nkallen/trigon/back.png

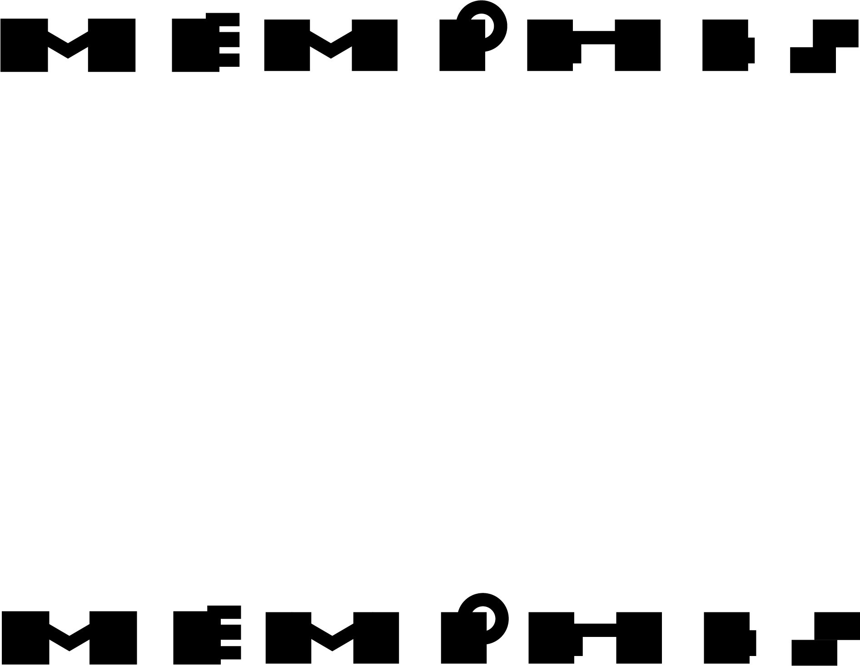
back.png
