nkallen/trigon/side.png

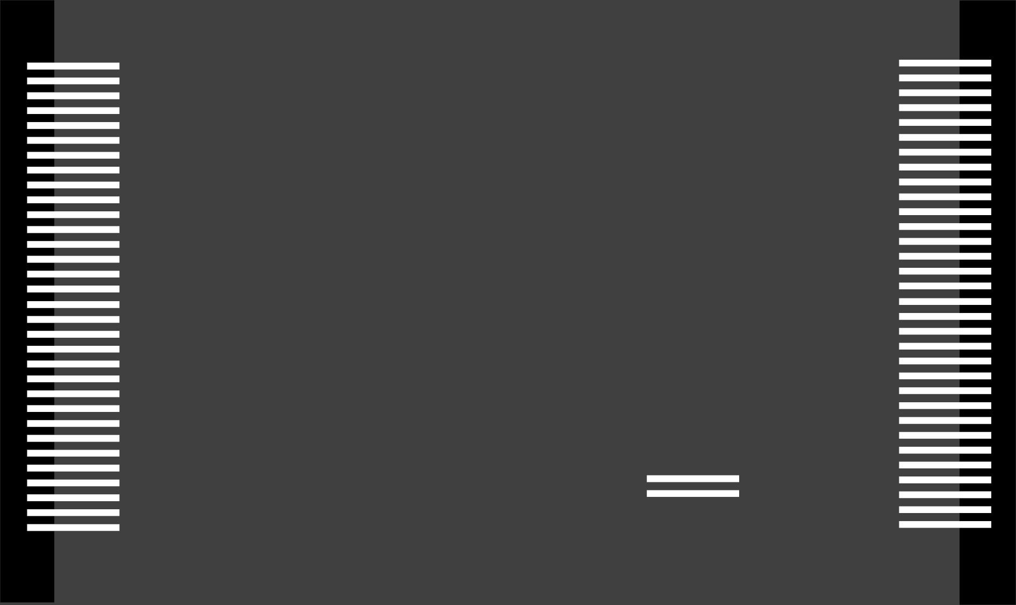
side.png
