nkallen/trigon/Gerbers/Trigon-Edge_Cuts.dxf

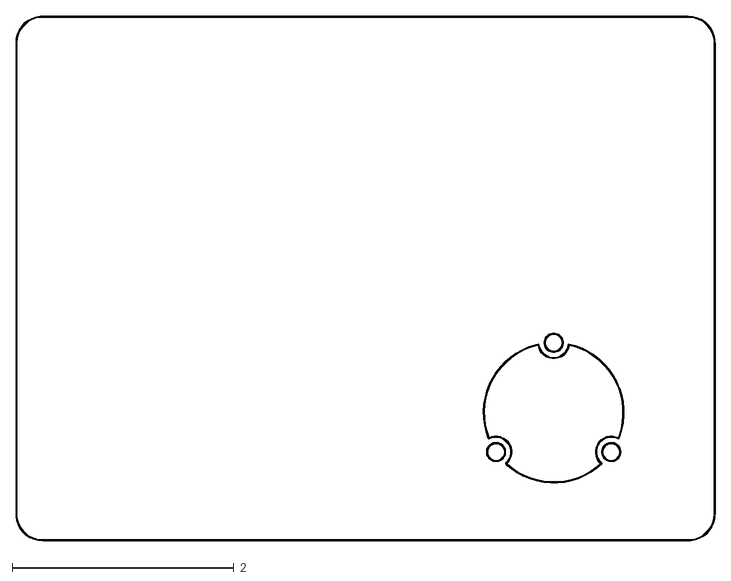
[picture p3: CAD file, 2021-04-19]
Gerbers/Trigon-Edge_Cuts.dxf
6.31 x 4.73
