nkallen/trigon/Case/Switch Plate v2.dxf

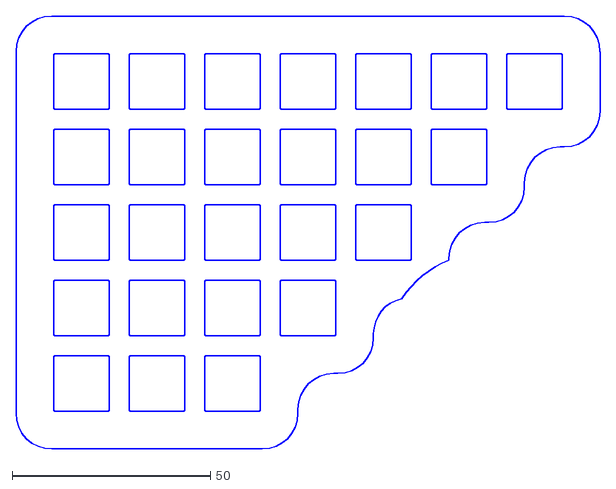
[picture p4: CAD file, 2021-04-19]
Case/Switch Plate v2.dxf
147.3 x 109.2
