nkallen/trigon/Case/backplate.dxf

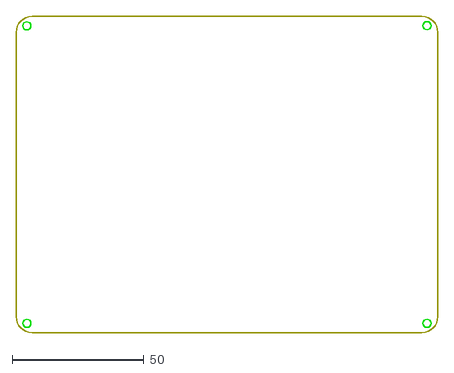
[picture p5: CAD file, 2021-04-19]
Case/backplate.dxf
160.0 x 120.0
