nkallen/trigon/Case/pcb 5.dxf

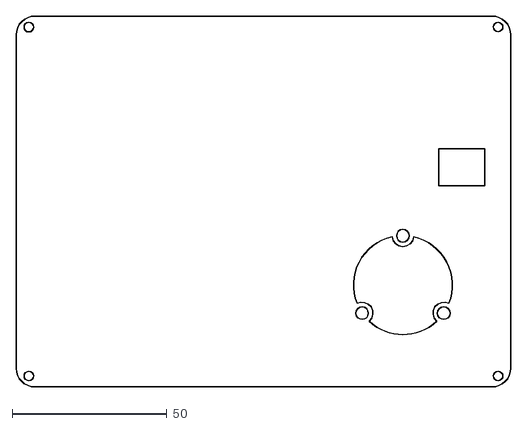
[picture p6: CAD file, 2020-09-24]
Case/pcb 5.dxf
160.0 x 120.0
