nkallen/trigon/Case/pcb 4.dxf

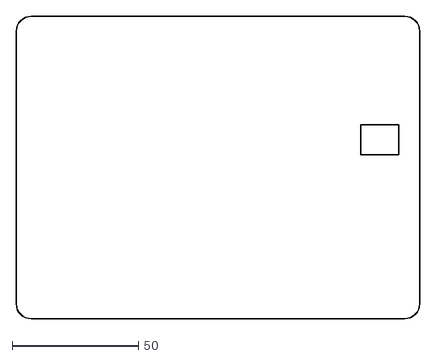
[picture p7: CAD file, 2020-09-24]
Case/pcb 4.dxf
160.0 x 120.0
