nkallen/trigon/Case/pcb 3.dxf

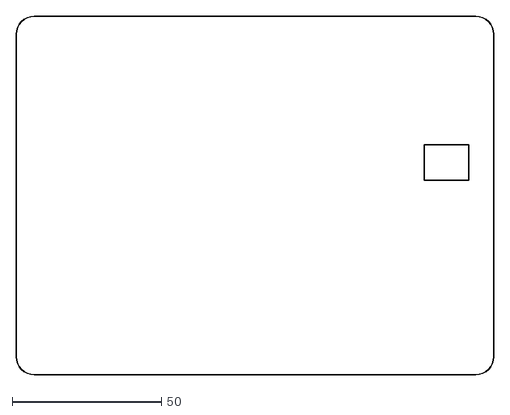
[picture p8: CAD file, 2020-09-24]
Case/pcb 3.dxf
160.0 x 120.0
