nkallen/trigon/Case/pcb.dxf

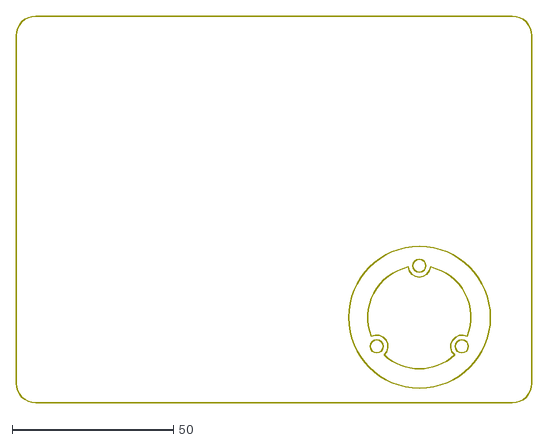
[picture p9: CAD file, 2020-09-11]
Case/pcb.dxf
160.0 x 120.0
