nkallen/trigon/(list of files, cad)

Other CAD files:
Case/Keyboard.dwg
Case/bottom.dxf
Case/top.dxf
Case/open 2.dxf
Case/open 0.dxf
Case/mount.dxf
Case/open 1.dxf
Case/open 3.dxf
Case/Switch Plate v1.dxf
Case/Switch Plate v0.dxf
