nkallen/trigon/Case/case.pdf

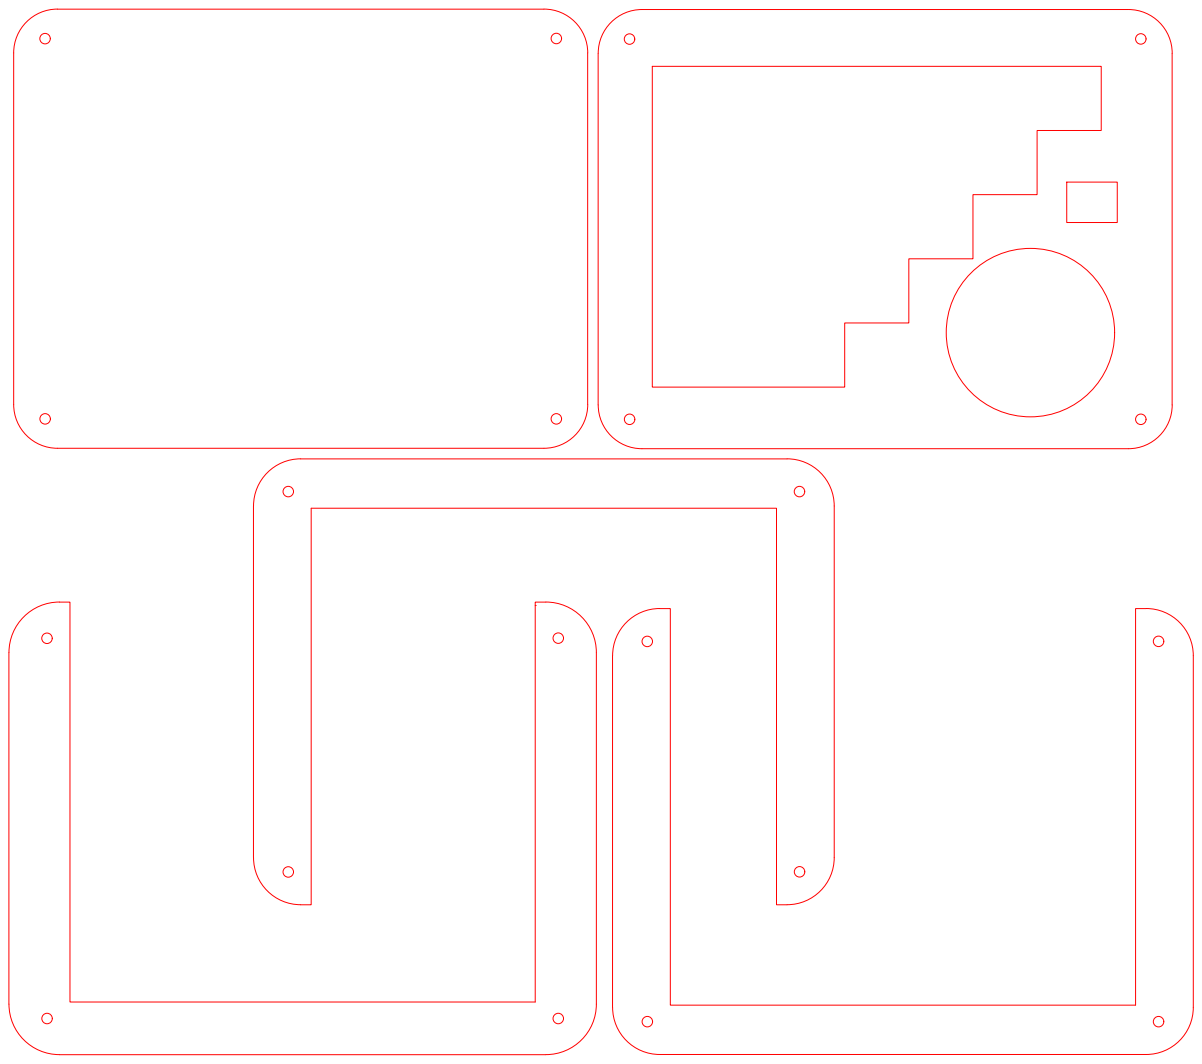
[picture p10: page 1]
