nkallen/trigon/Gerbers/Trigon-Edge_Cuts.pdf

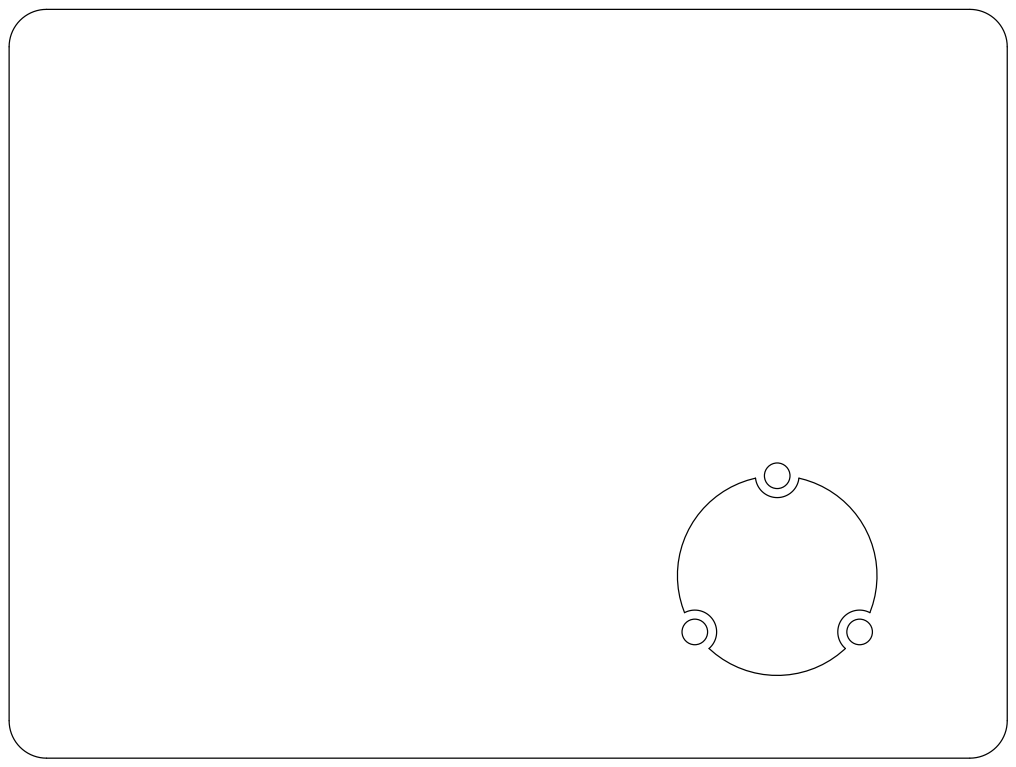
[picture p11: page 1]
