nkallen/trigon/Gerbers/Trigon-F_Cu.pdf

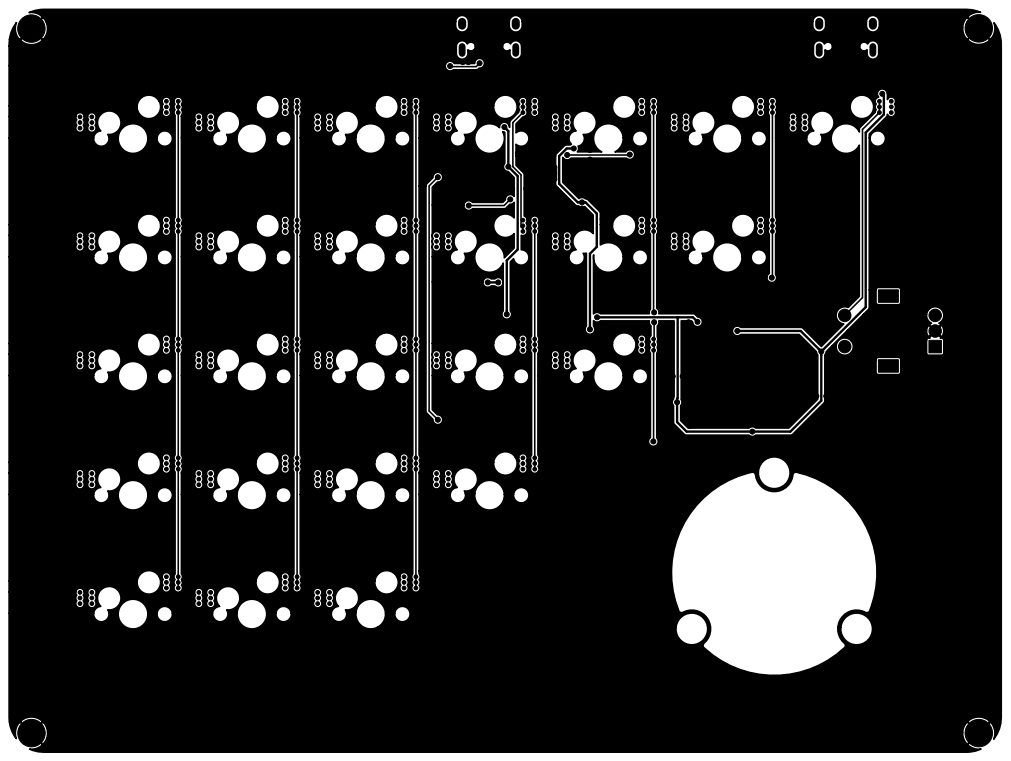
[picture p12: page 1]
