nkallen/trigon/Gerbers/Trigon-F_Fab.pdf

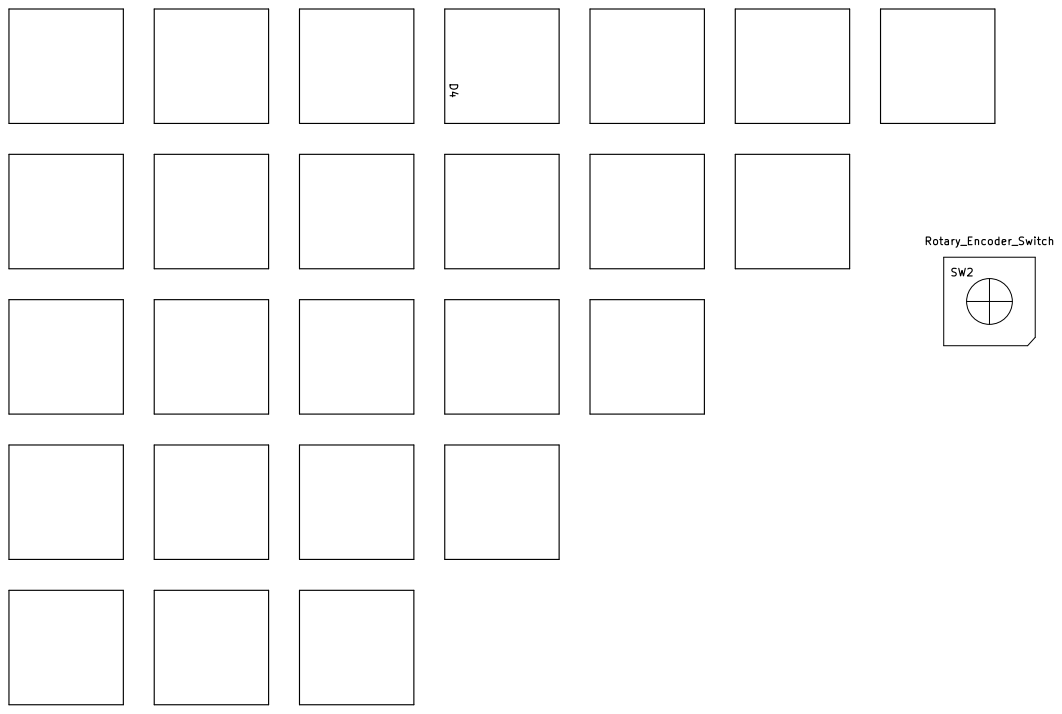
[picture p13: page 1]
