nkallen/trigon/Hardware/Trigon.kicad_pcb

## KiCad design Hardware/Trigon.kicad_pcb (2021-04-20)

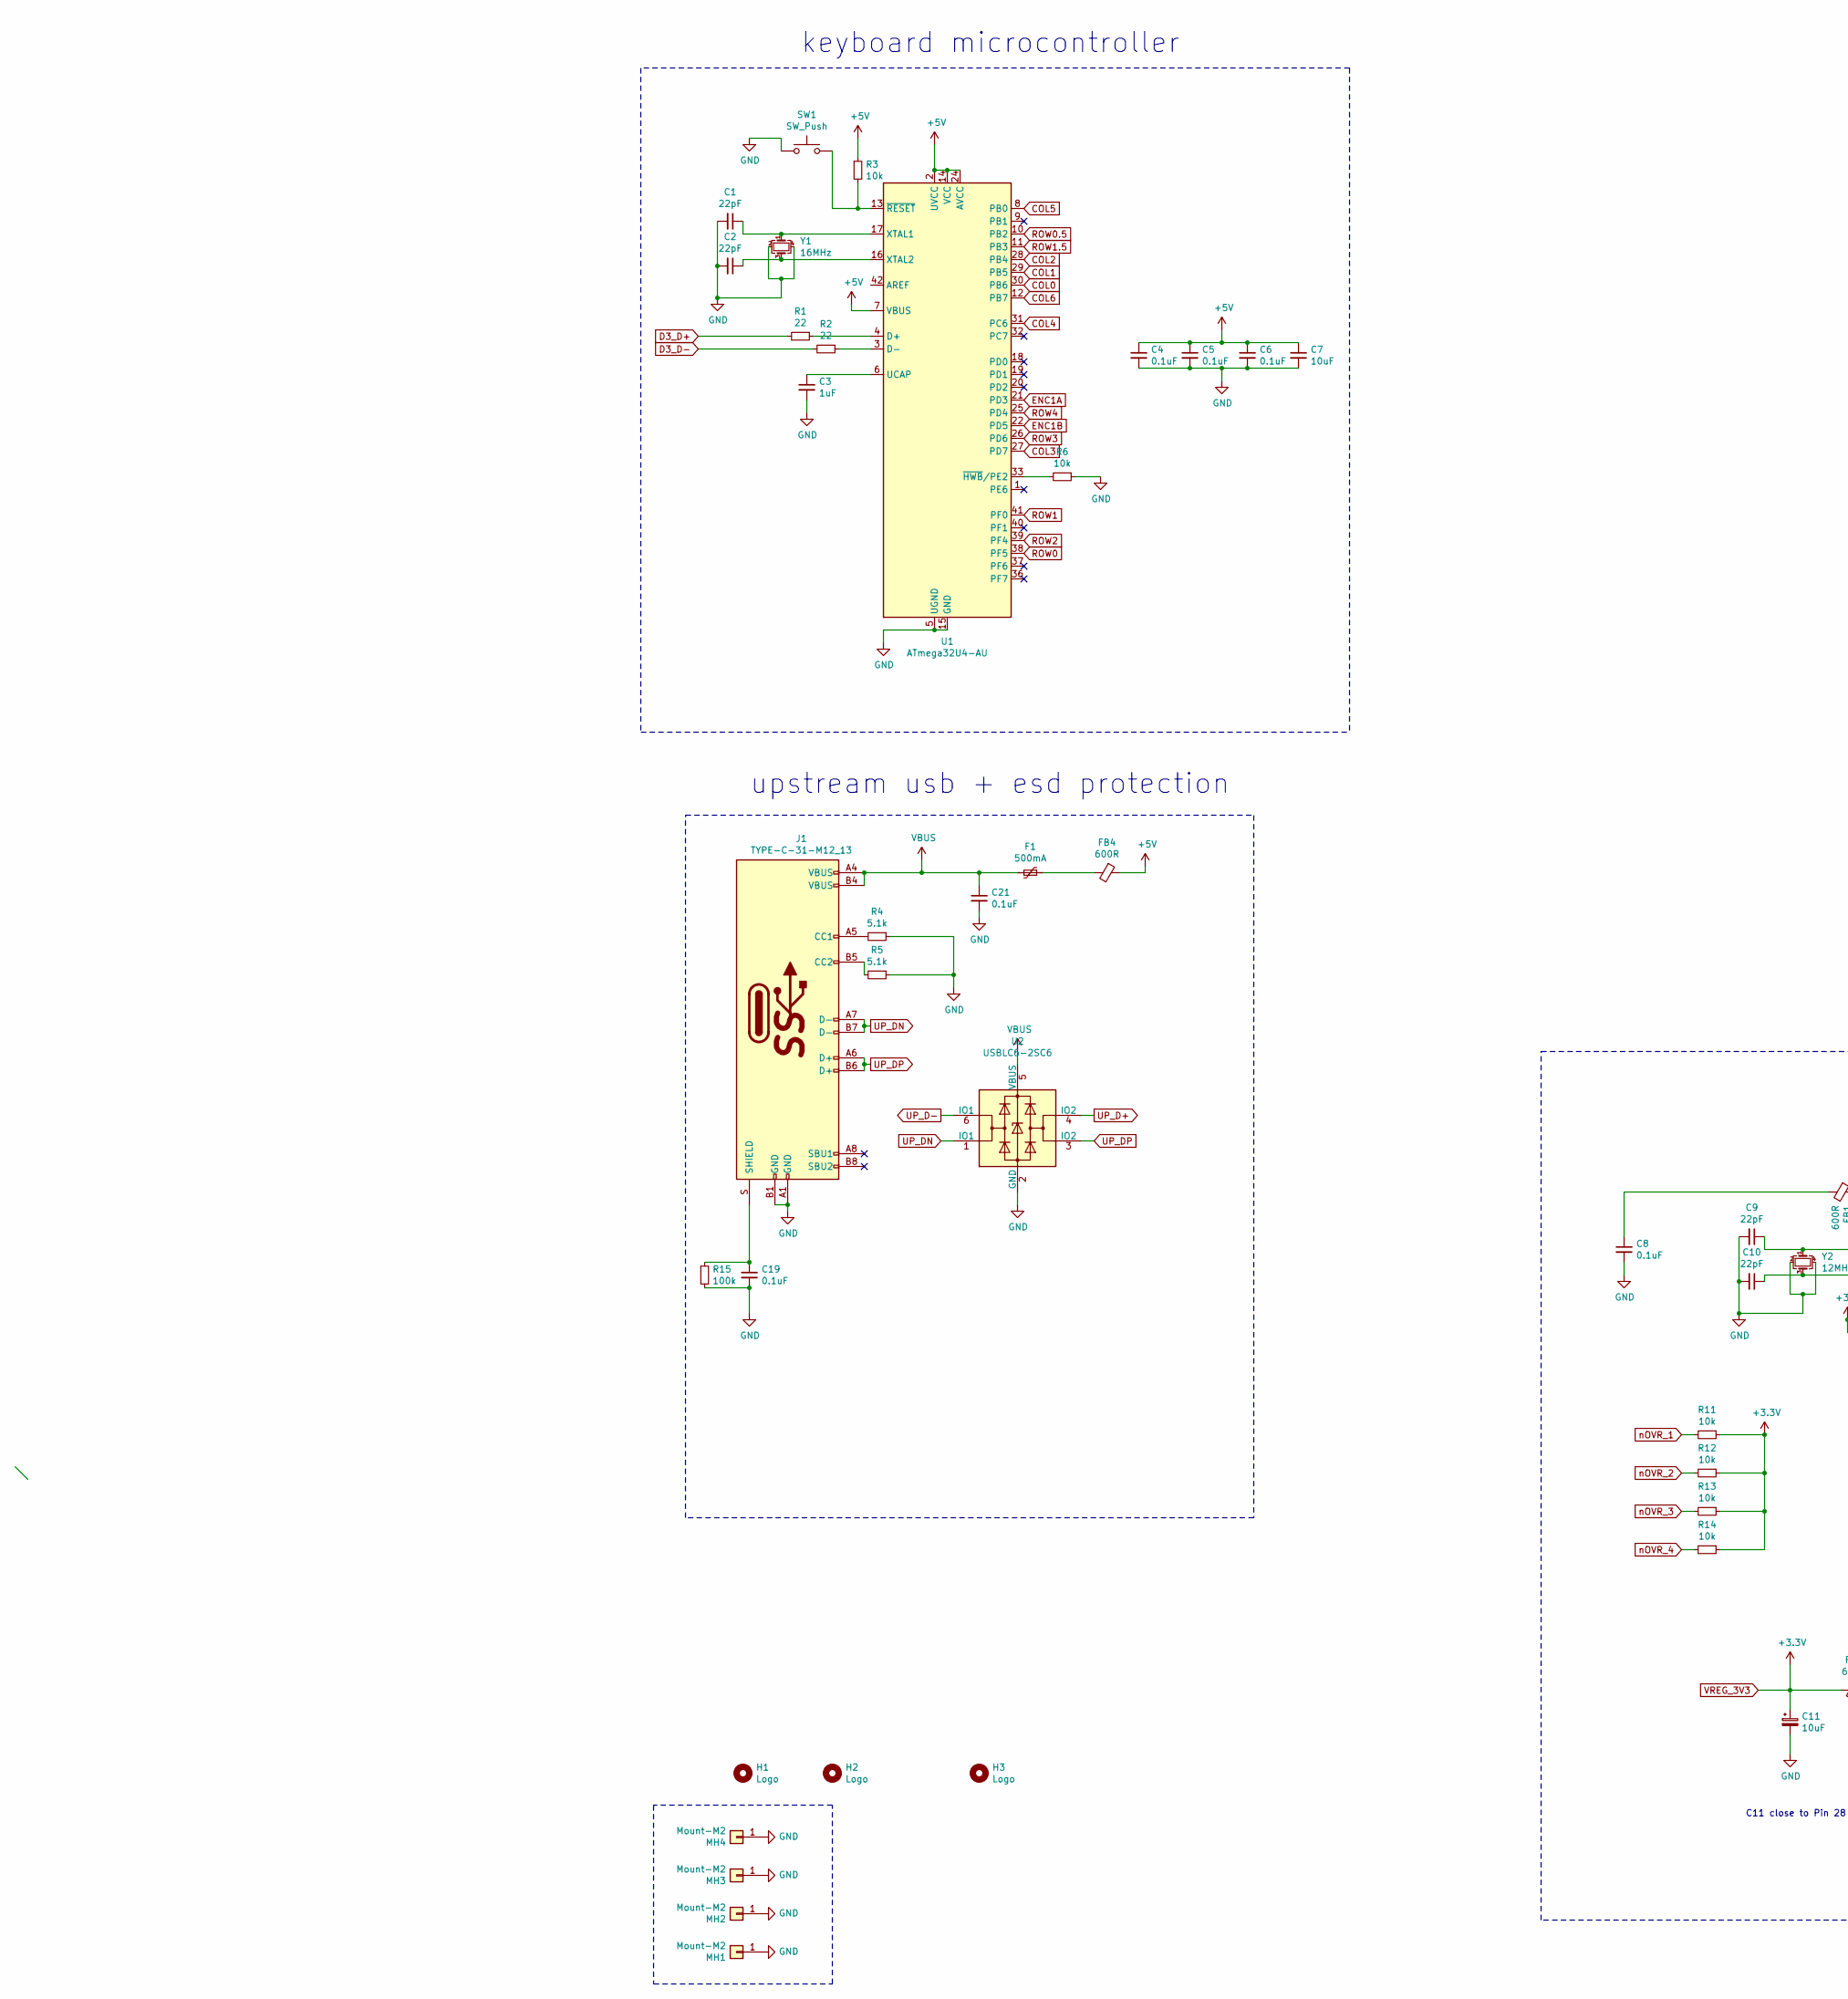
[picture p14: schematic Trigon.sch, part in row 1, column 1]

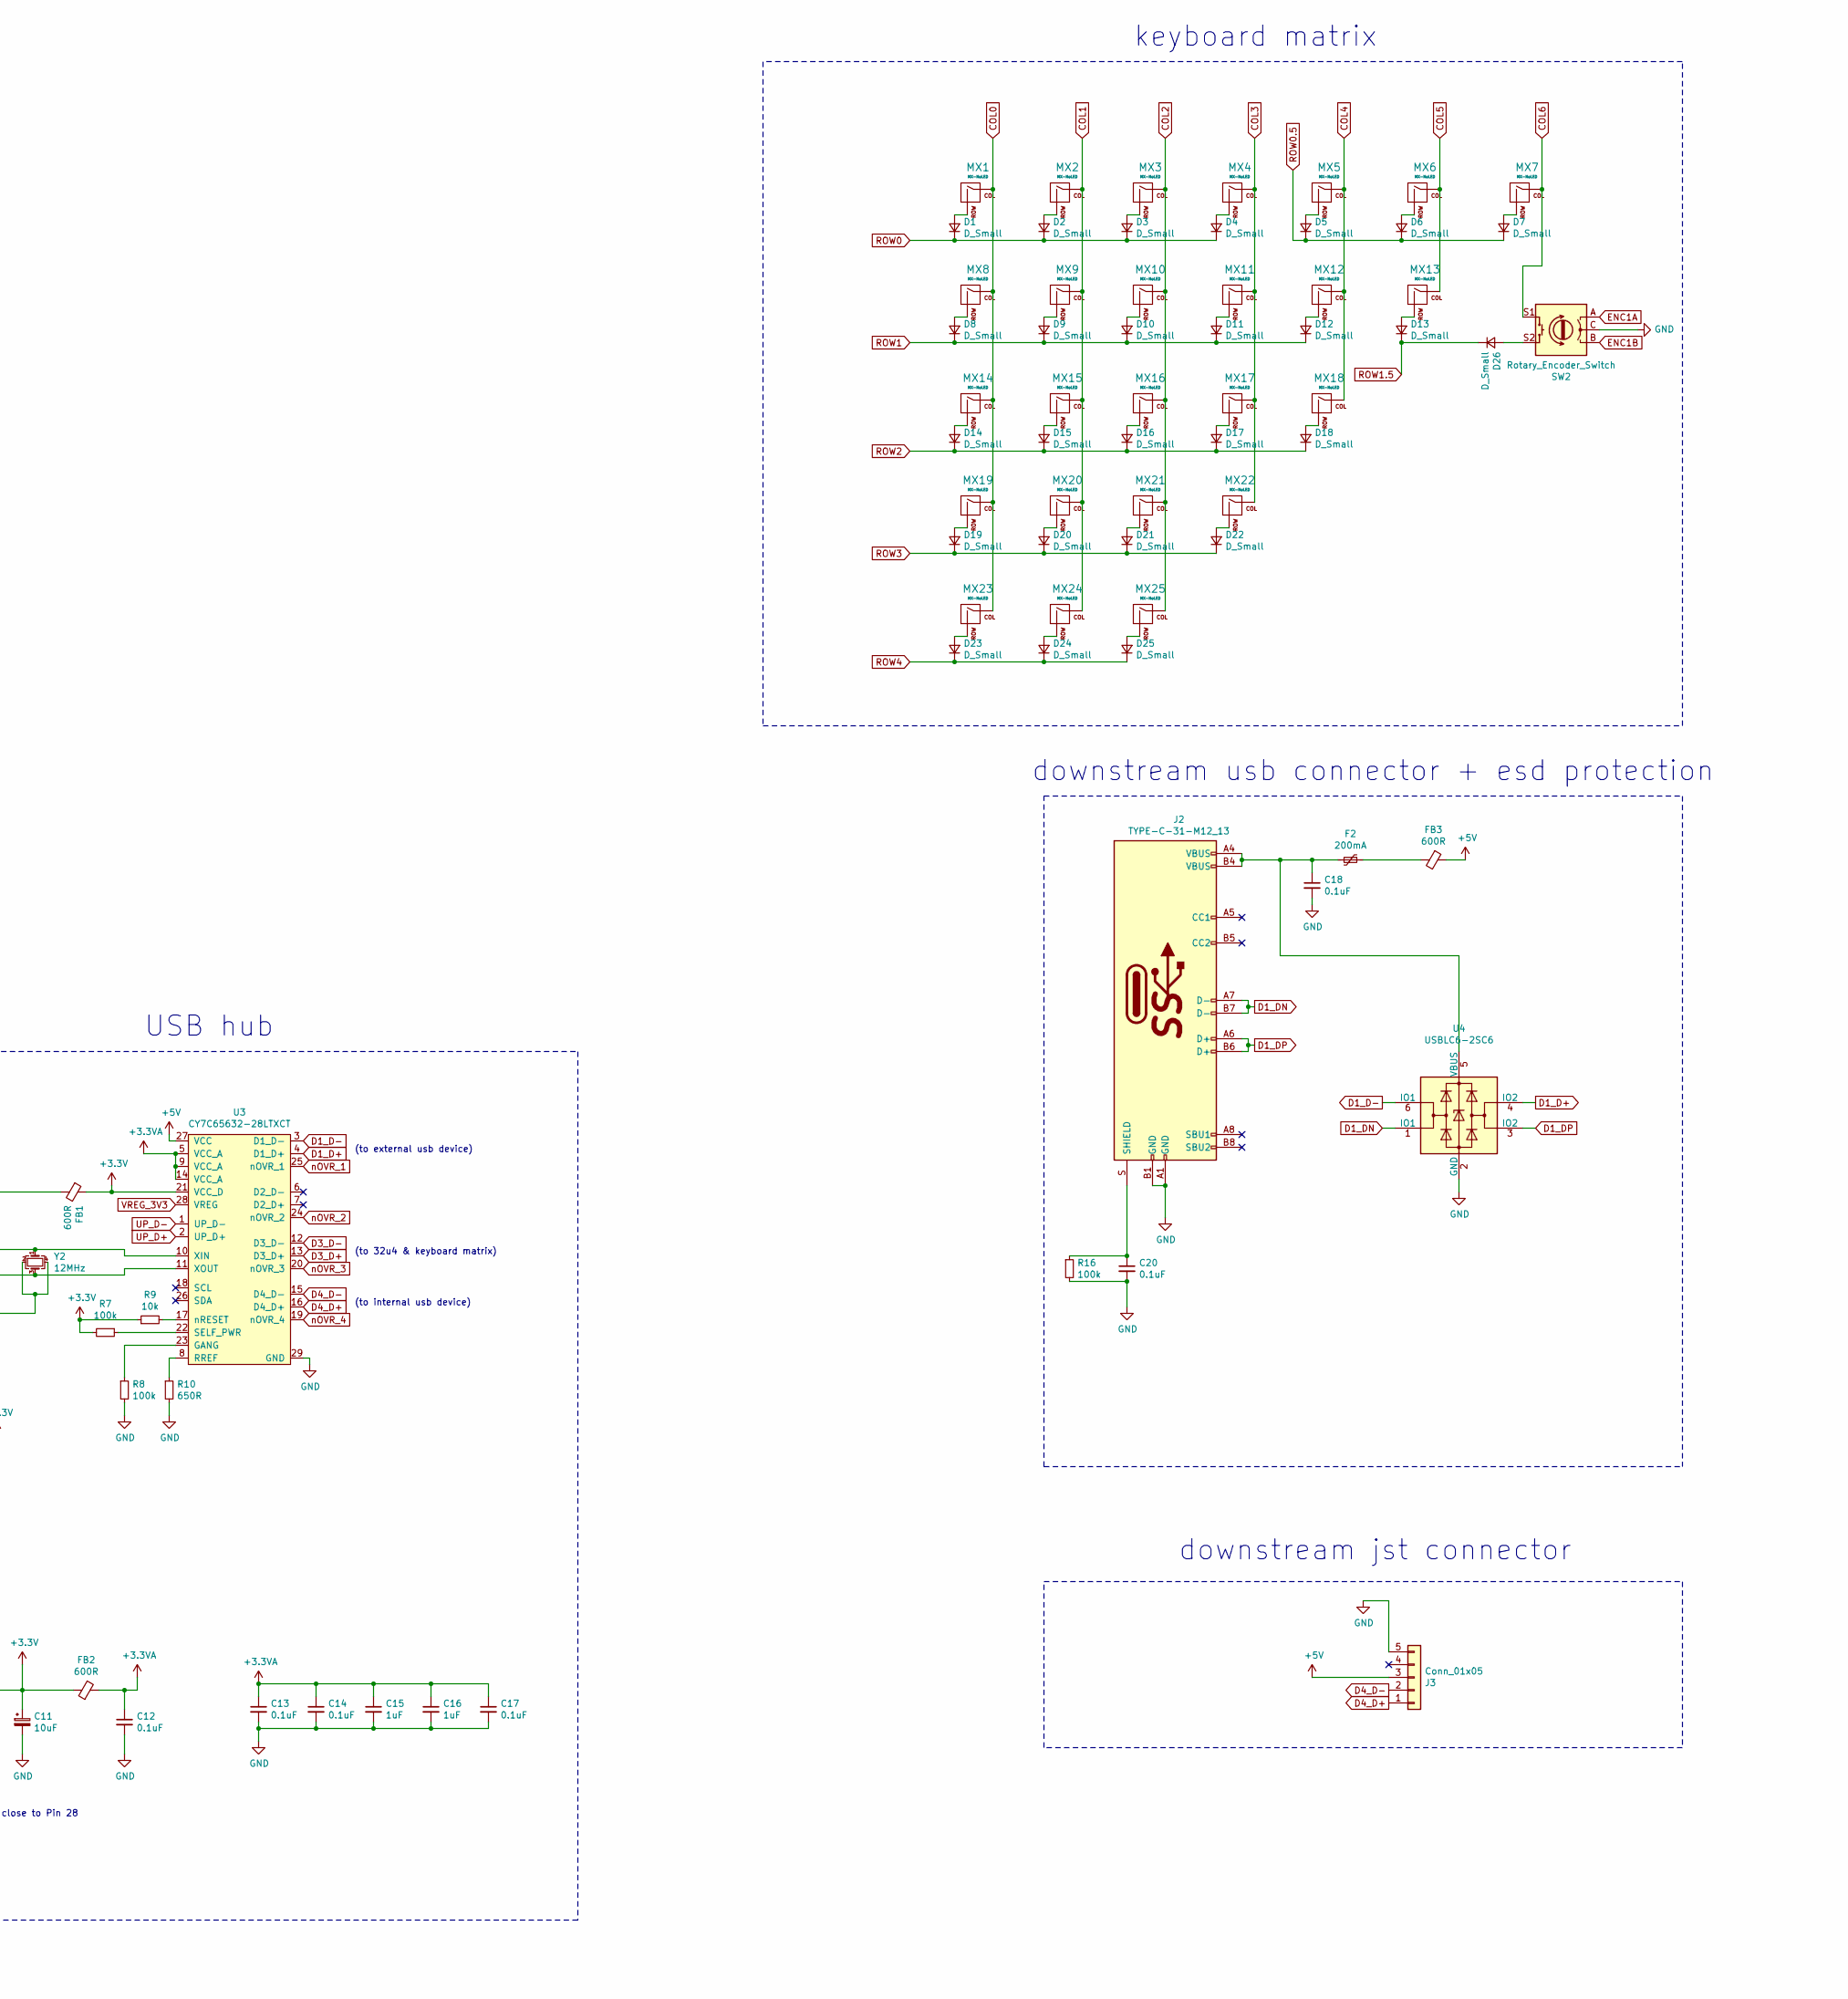
[picture p15: schematic Trigon.sch, part in row 1, column 2]

Parts:
C1, C2, C9, C10: 22pF; C_0603_1608Metric; Manufacturer Part # CL10C220JB8NNNC
C3, C15, C16: 1uF; C_0603_1608Metric; Manufacturer Part # CL10A105KB8NNNC
C4, C5, C6, C8, C12, C13, C14, C17, C18, C19, C20, C21: 0.1uF; C_0603_1608Metric; Manufacturer Part # CC0603KRX7R9BB104
C7, C11: 10uF; C_0603_1608Metric; Manufacturer Part # CL10A106KP8NNNC
D1, D2, D3, D4, D5, D6, D7, D8, D9, D10, D11, D12, D13, D14, D15, D16, D17, D18, D19, D20, D21, D22, D23, D24, D25, D26: D_Small; D_SOD-123; Manufacturer Part # 1N4148W
F1: 500mA; Fuse_1206_3216Metric; Manufacturer Part # 1206L050YR
F2: 200mA; Fuse_1206_3216Metric; Manufacturer Part # 1206L020YR
FB1, FB2, FB3, FB4: 600R; Ferrite_Bead_0603; Manufacturer Part # BLM18AG601SN1D
H1: Logo; wiggle
H2: Logo; back
H3: Logo; backside
J1, J2: TYPE-C-31-M12_13; TYPE-C-31-M-12; Manufacturer Part # TYPE-C-31-M-12
J3: Conn_01x05; JST_SH_SM05B-SRSS-TB_1x05-1MP_P1.00mm_Horizontal; Manufacturer Part # SM05B-SRSS-TB(LF)(SN)
MH1, MH2, MH3, MH4: Mount-M2; MountingHole_3.2mm_M3_Pad_v2
MX1, MX2, MX3, MX4, MX5, MX6, MX7, MX8, MX9, MX10, MX11, MX12, MX13, MX14, MX15, MX16, MX17, MX18, MX19, MX20, MX21, MX22, MX23, MX24, MX25: MX-NoLED; Kailh_Hotswap_1U
R1, R2: 22; R_0603_1608Metric; Manufacturer Part # 0603WAF220JT5E
R3, R6, R9, R11, R12, R13, R14: 10k; R_0603_1608Metric; Manufacturer Part # 0603WAF1002T5E
R4, R5: 5.1k; R_0603_1608Metric; Manufacturer Part # 0603WAF5101T5E
R7, R8, R15, R16: 100k; R_0603_1608Metric; Manufacturer Part # 0603WAF1003T5E
R10: 650R; R_0603_1608Metric; Manufacturer Part # 0603WAF6490T5E
SW1: SW_Push; SKQG-1155865; Manufacturer Part # TS-1187A-B-A-B
SW2: Rotary_Encoder_Switch; RotaryEncoder_Alps_EC11E-Switch_Vertical_H20mm
U1: ATmega32U4-AU; TQFP-44_10x10mm_P0.8mm; Manufacturer Part # ATMEGA32U4-AU
U2, U4: USBLC6-2SC6; SOT-23-6; Manufacturer Part # USBLC6-2SC6
U3: CY7C65632-28LTXCT; QFN-28-1EP_5x5mm_P0.5mm_EP3.35x3.35mm_ThermalVias; Manufacturer Part # CY7C65632-28LTXCT
Y1: 16MHz; Crystal_SMD_3225-4Pin_3.2x2.5mm; Manufacturer Part # X322516MRB4SI
Y2: 12MHz; Crystal_SMD_3225-4Pin_3.2x2.5mm; Manufacturer Part # X322512MSB4SI

Connections:
+3.3VA: C12.1, C13.1, C14.1, C15.1, C16.1, C17.1, FB2.2, U3.5 (VCC_A), U3.9 (VCC_A), U3.14 (VCC_A)
+5V: C4.1, C5.1, C6.1, C7.1, FB3.1, FB4.1, J3.3, R3.1, U1.2 (UVCC), U1.7 (VBUS), U1.14 (VCC), U1.24 (AVCC), U1.34 (VCC), U1.44 (AVCC), U3.27 (VCC)
COL0: MX1.1 (COL), MX8.1 (COL), MX14.1 (COL), MX19.1 (COL), MX23.1 (COL), U1.30 (PB6)
COL1: MX2.1 (COL), MX9.1 (COL), MX15.1 (COL), MX20.1 (COL), MX24.1 (COL), U1.29 (PB5)
COL2: MX3.1 (COL), MX10.1 (COL), MX16.1 (COL), MX21.1 (COL), MX25.1 (COL), U1.28 (PB4)
COL3: MX4.1 (COL), MX11.1 (COL), MX17.1 (COL), MX22.1 (COL), U1.27 (PD7)
COL4: MX5.1 (COL), MX12.1 (COL), MX18.1 (COL), U1.31 (PC6)
COL5: MX6.1 (COL), MX13.1 (COL), U1.8 (PB0)
COL6: MX7.1 (COL), SW2.S1, U1.12 (PB7)
D1_D+: U3.4 (D1_D+), U4.4 (IO2)
D1_D-: U3.3 (D1_D-), U4.6 (IO1)
D1_DN: J2.A7 (D-), J2.B7 (D-), U4.1 (IO1)
D1_DP: J2.A6 (D+), J2.B6 (D+), U4.3 (IO2)
D3_D+: R1.2, U3.13 (D3_D+)
D3_D-: R2.2, U3.12 (D3_D-)
D4_D+: J3.1, U3.16 (D4_D+)
D4_D-: J3.2, U3.15 (D4_D-)
ENC1A: SW2.A, U1.21 (PD3)
ENC1B: SW2.B, U1.22 (PD5)
GND: C1.2, C2.2, C3.2, C4.2, C5.2, C6.2, C7.2, C8.2, C9.2, C10.2, C11.2, C12.2, C13.2, C14.2, C15.2, C16.2, C17.2, C18.2, C19.2, C20.2, C21.2, J1.A1 (GND), J1.B1 (GND), J2.A1 (GND), J2.B1 (GND), J3.5, MH1.1, MH2.1, MH3.1, MH4.1, R4.1, R5.1, R6.1, R8.2, R10.2, R15.2, R16.2, SW1.1, SW2.C, U1.5 (UGND), U1.15 (GND), U1.23 (GND), U1.35 (GND), U1.43 (GND), U2.2 (GND), U3.29 (GND), U4.2 (GND), Y1.2, Y1.4, Y2.2, Y2.4
unnamed: C1.1, U1.17 (XTAL1), Y1.1
unnamed: C2.1, U1.16 (XTAL2), Y1.3
unnamed: C3.1, U1.6 (UCAP)
unnamed: C8.1, FB1.2
unnamed: C9.1, U3.10 (XIN), Y2.1
unnamed: C10.1, U3.11 (XOUT), Y2.3
unnamed: C18.1, F2.2, J2.A4 (VBUS), J2.B4 (VBUS), U4.5 (VBUS)
unnamed: C19.1, J1.S (SHIELD), R15.1
unnamed: C20.1, J2.S (SHIELD), R16.1
unnamed: D1.2 (A), MX1.2 (ROW)
unnamed: D2.2 (A), MX2.2 (ROW)
unnamed: D3.2 (A), MX3.2 (ROW)
unnamed: D4.2 (A), MX4.2 (ROW)
unnamed: D5.2 (A), MX5.2 (ROW)
unnamed: D6.2 (A), MX6.2 (ROW)
unnamed: D7.2 (A), MX7.2 (ROW)
unnamed: D8.2 (A), MX8.2 (ROW)
unnamed: D9.2 (A), MX9.2 (ROW)
unnamed: D10.2 (A), MX10.2 (ROW)
unnamed: D11.2 (A), MX11.2 (ROW)
unnamed: D12.2 (A), MX12.2 (ROW)
unnamed: D13.2 (A), MX13.2 (ROW)
unnamed: D14.2 (A), MX14.2 (ROW)
unnamed: D15.2 (A), MX15.2 (ROW)
unnamed: D16.2 (A), MX16.2 (ROW)
unnamed: D17.2 (A), MX17.2 (ROW)
unnamed: D18.2 (A), MX18.2 (ROW)
unnamed: D19.2 (A), MX19.2 (ROW)
unnamed: D20.2 (A), MX20.2 (ROW)
unnamed: D21.2 (A), MX21.2 (ROW)
unnamed: D22.2 (A), MX22.2 (ROW)
unnamed: D23.2 (A), MX23.2 (ROW)
unnamed: D24.2 (A), MX24.2 (ROW)
unnamed: D25.2 (A), MX25.2 (ROW)
unnamed: D26.2 (A), SW2.S2
unnamed: F1.1, FB4.2
unnamed: F2.1, FB3.2
unnamed: J1.A5 (CC1), R4.2
unnamed: J1.B5 (CC2), R5.2
unnamed: R1.1, U1.4 (D+)
unnamed: R2.1, U1.3 (D-)
unnamed: R3.2, SW1.2, U1.13 (~RESET)
unnamed: R6.2, U1.33 (~HWB~/PE2)
unnamed: R7.1, U3.22 (SELF_PWR)
unnamed: R8.1, U3.23 (GANG)
unnamed: R9.2, U3.17 (nRESET)
unnamed: R10.1, U3.8 (RREF)
ROW0: D1.1 (K), D2.1 (K), D3.1 (K), D4.1 (K), U1.38 (PF5)
ROW0.5: D5.1 (K), D6.1 (K), D7.1 (K), U1.10 (PB2)
ROW1: D8.1 (K), D9.1 (K), D10.1 (K), D11.1 (K), D12.1 (K), U1.41 (PF0)
ROW1.5: D13.1 (K), D26.1 (K), U1.11 (PB3)
ROW2: D14.1 (K), D15.1 (K), D16.1 (K), D17.1 (K), D18.1 (K), U1.39 (PF4)
ROW3: D19.1 (K), D20.1 (K), D21.1 (K), D22.1 (K), U1.26 (PD6)
ROW4: D23.1 (K), D24.1 (K), D25.1 (K), U1.25 (PD4)
UP_D+: U2.4 (IO2), U3.2 (UP_D+)
UP_D-: U2.6 (IO1), U3.1 (UP_D-)
UP_DN: J1.A7 (D-), J1.B7 (D-), U2.1 (IO1)
UP_DP: J1.A6 (D+), J1.B6 (D+), U2.3 (IO2)
VBUS: C21.1, F1.2, J1.A4 (VBUS), J1.B4 (VBUS), U2.5 (VBUS)
VREG_3V3: C11.1, FB1.1, FB2.1, R7.2, R9.1, R11.1, R12.1, R13.1, R14.1, U3.21 (VCC_D), U3.28 (VREG)
nOVR_1: R11.2, U3.25 (nOVR_1)
nOVR_2: R12.2, U3.24 (nOVR_2)
nOVR_3: R13.2, U3.20 (nOVR_3)
nOVR_4: R14.2, U3.19 (nOVR_4)

Notes on the sheet:
(to 32u4 & keyboard matrix)
(to internal usb device)
(to external usb device)
C11 close to Pin 28
keyboard matrix
keyboard microcontroller
upstream usb + esd protection
USB hub
downstream usb connector + esd protection
downstream jst connector

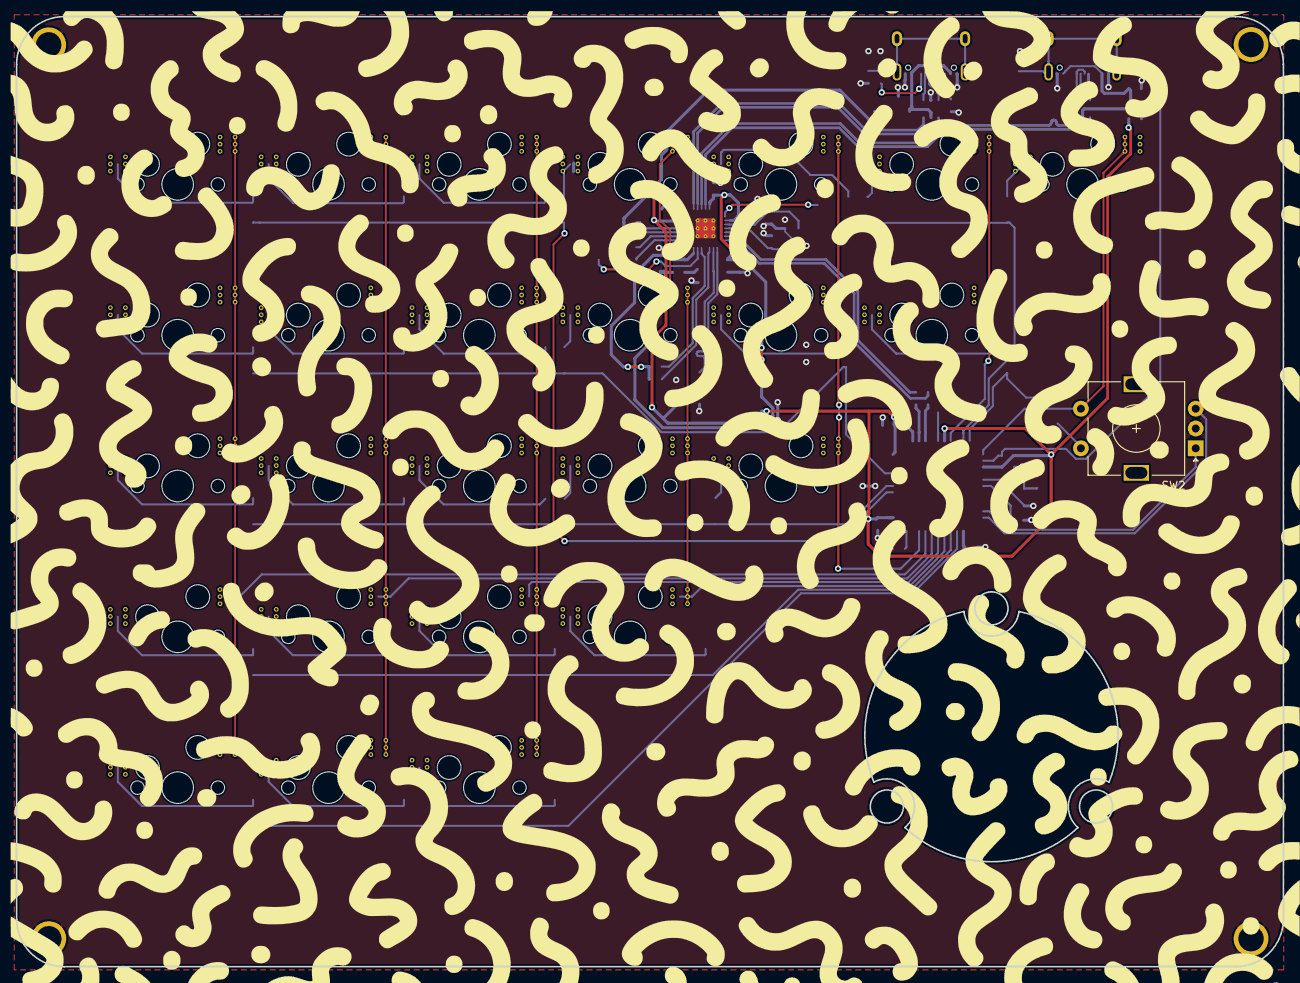
[picture p16: board Trigon.kicad_pcb from above]

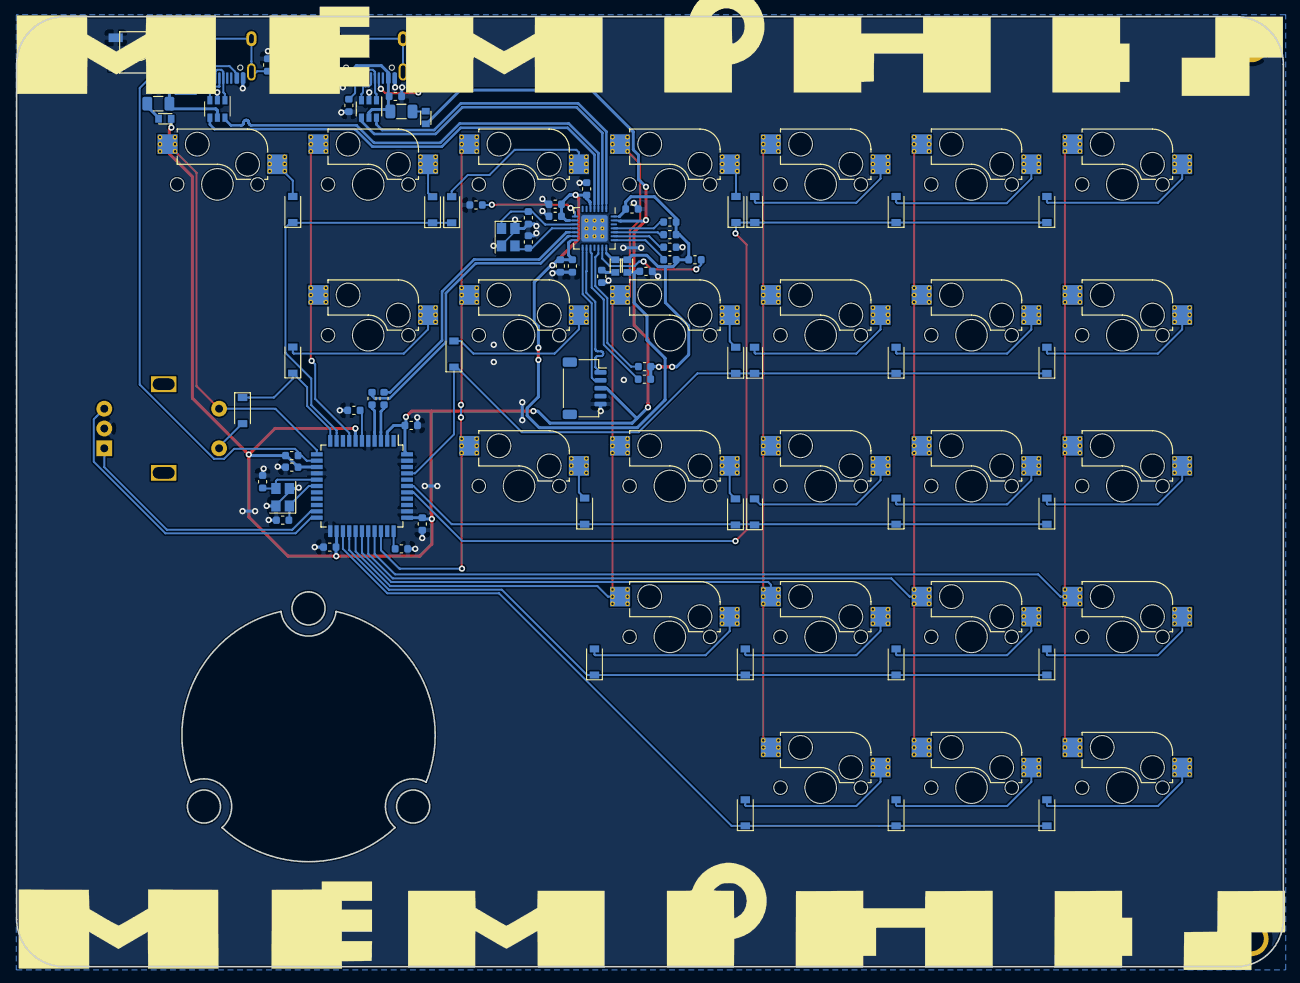
[picture p17: board Trigon.kicad_pcb from below]

Board: 2 copper layers, 160.0 x 120.0 mm, 112 parts (109 on the bottom side), 84 nets.
