nkallen/trigon/(commit log)

2020-07-08 ProMicro etc
    [Trigon.sch]
2020-07-08 Fully laid out board
    [Trigon.kicad_pcb, Trigon.sch]
2020-07-08 dxf files
    [Switch Plate v0.dxf, bottom v0.dxf, open fat v0.dxf, open thin v0.dxf, top v0.dxf]
2020-07-09 onboard usb c
    [Trigon.sch]
2020-07-10 routed without rows cols
    [Trigon.kicad_pcb, Trigon.sch]
2020-07-10 fully routed matrix
    [Trigon.kicad_pcb, Trigon.sch]
2020-07-10 incorporate feedback
    [Trigon.kicad_pcb]
2020-07-10 full ground fill
    [Trigon.kicad_pcb]
2020-07-10 decorative stuff
    [Trigon.kicad_pcb]
2020-07-11 all on one side
    [Trigon-B_Cu.gbl, Trigon-B_Mask.gbs, Trigon-B_Paste.gbp, Trigon-B_SilkS.gbo, Trigon-Edge_Cuts.gm1, Trigon-F_Cu.gtl, Trigon-F_Mask.gts, Trigon-F_Paste.gtp]
2020-07-11 bring back masq
    [Trigon.kicad_pcb]
2020-07-12 cleaning up ground plane for solder mask layer
    [Trigon-B_Cu.gbl, Trigon-B_Mask.gbs, Trigon-B_Paste.gbp, Trigon-B_SilkS.gbo, Trigon-Edge_Cuts.gm1, Trigon-F_Cu.gtl, Trigon-F_Mask.gts, Trigon-F_Paste.gtp]
2020-07-12 new usb connector'
    [Trigon-B_Cu.gbl, Trigon-B_Mask.gbs, Trigon-B_Paste.gbp, Trigon-B_SilkS.gbo, Trigon-Edge_Cuts.gm1, Trigon-F_Cu.gtl, Trigon-F_Mask.gts, Trigon-F_Paste.gtp]
2020-08-11 USB hub
    [Trigon.sch]
2020-08-12 usb hub pcb layout
    [Trigon.kicad_pcb, Trigon.sch]
2020-08-12 changes to fuse values per joshajohnson
    [Trigon.sch]
2020-08-13 More compact layout
    [Trigon.kicad_pcb, Trigon.sch]
2020-08-13 incorporating josh's feedback
    [Trigon.kicad_pcb, Trigon.sch]
2020-08-14 next round of feedback from josh
    [Trigon.kicad_pcb, Trigon.sch]
2020-08-14 - Introduced JST connector - Made all D+/D- 14mm thick (max thickness that was easy to deal with) - Added logo / decoration / version #
    [Trigon.kicad_pcb, Trigon.sch]
2020-08-14 Reorganized files
    [Switch Plate v0.dxf, Trigon.kicad_pcb, Trigon.sch, bottom v0.dxf, open fat v0.dxf, open thin v0.dxf, top v0.dxf]
2020-08-14 Case info
    [Keyboard.dwg, Switch Plate v1.dxf]
2020-08-15 minor tweaks to layout
    [Trigon.kicad_pcb]
2020-08-15 crystal load
    [Trigon.sch]
2020-08-15 more space for usb
    [Trigon.kicad_pcb]
2020-08-15 min track width
    [Trigon.kicad_pcb]
2020-08-15 some via weirdness
    [Trigon.kicad_pcb]
2020-08-15 Pad size of U3.29 was too small
    [Trigon.kicad_pcb]
2020-08-15 Addressing pcbway complaints of min track width
    [Trigon-B_Cu.gbl, Trigon-B_Mask.gbs, Trigon-B_SilkS.gbo, Trigon-Edge_Cuts.gm1, Trigon-F_Cu.gtl, Trigon-F_Mask.gts, Trigon-F_SilkS.gto, Trigon-NPTH.drl]
2020-08-16 New layout
    [Trigon.kicad_pcb, Trigon.sch]
2020-08-17 Latest bom/gerbers; reflecting more of josh's comments
    [Trigon-B_Cu.gbl, Trigon-B_Mask.gbs, Trigon-B_Paste.gbp, Trigon-B_SilkS.gbo, Trigon-Edge_Cuts.gm1, Trigon-F_Cu.gtl, Trigon-F_Mask.gts, Trigon-F_Paste.gtp]
2020-09-10 introducing new naming convention for case
    [bottom.dxf, open 0.dxf, open 1.dxf, open 2.dxf, open 3.dxf, top.dxf]
2020-09-11 Updates to case
    [Keyboard.dwg, Trigon.kicad_pcb, Trigon.sch, bottom.dxf, open 4.dxf, pcb.dxf, top.dxf]
2020-09-24 add html bom
2020-10-06 kailh hotswap switches ;now using a fixed acheron
    [Trigon.kicad_pcb, Trigon.sch]
2020-10-25 using hotswaps
    [Trigon-B_Cu.gbl, Trigon-B_Mask.gbs, Trigon-B_Paste.gbp, Trigon-B_SilkS.gbo, Trigon-Edge_Cuts.gm1, Trigon-F_Cu.gtl, Trigon-F_Mask.gts, Trigon-F_SilkS.gto]
2020-11-10 Cleanup of incorrect pins
    [Trigon.sch]
2021-04-19 lots of changes
    [Keyboard.dwg, Switch Plate v2.dxf, Trigon-Edge_Cuts.dxf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]
2021-04-20 preping for pcbway
    [Trigon-B_Cu.gbl, Trigon-B_Mask.gbs, Trigon-B_Paste.gbp, Trigon-B_SilkS.gbo, Trigon-Edge_Cuts.gm1, Trigon-F_Cu.gtl, Trigon-F_Mask.gts, Trigon-F_SilkS.gto]
